LA-Solarpunk/free_fridges_monitoring/Hardware/monitoring_system_schematic/monitoring_system_schematic.kicad_sch

## KiCad design Hardware/monitoring_system_schematic/monitoring_system_schematic.kicad_sch (2026-09-17)

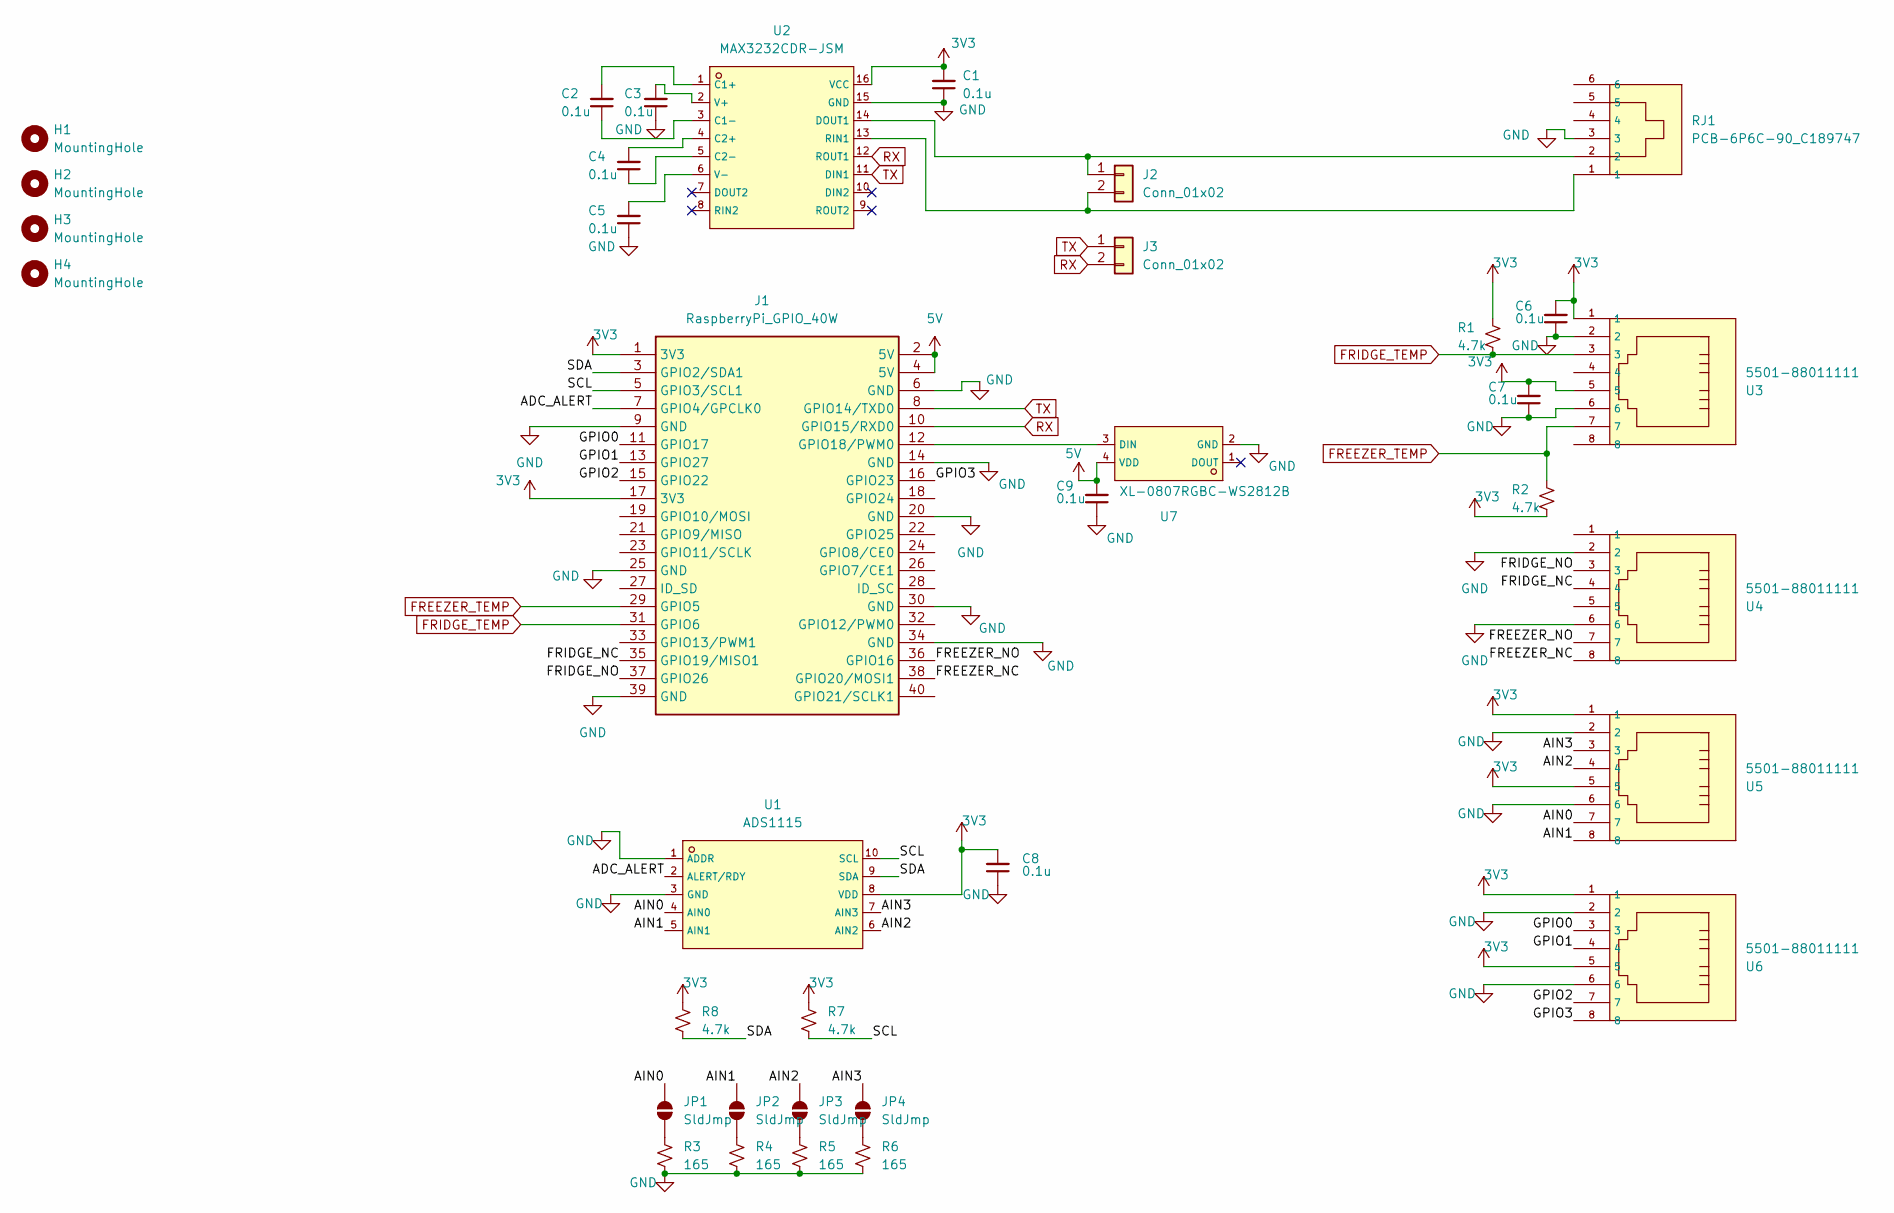
[picture p1: schematic monitoring_system_schematic.kicad_sch]

Parts:
C1, C2, C3, C4, C5, C6, C7, C8, C9: 0.1u; C307331_C0402; LCSC C307331
H1, H2, H3, H4: MountingHole; MountingHole_2.7mm_M2.5_Pad_Via
J1: RaspberryPi_GPIO_40W; RPi_Zero_ModelB_40W_Carrier; LCSC C132132
J2, J3: Conn_01x02; PinHeader_1x02_P2.54mm_Vertical
JP1, JP2, JP3, JP4: SldJmp; SolderJumper-2_P1.3mm_Open_RoundedPad1.0x1.5mm
R1, R2, R7, R8: 4.7k; C25900_R0402; LCSC C25900
R3, R4, R5, R6: 165; C706217_R0805; LCSC C706217
RJ1: PCB-6P6C-90_C189747; C189747_RJ11-TH_PCB-6P6C-90; LCSC C189747
U1: ADS1115; C37593_MSOP-10_L3_0-W3_0-P0_50-LS5_0-BL; LCSC C37593
U2: MAX3232CDR-JSM; C46596312_SOIC-16_L9_9-W3_9-P1_27-LS6_1-BL; LCSC C46596312
U3, U4, U5, U6: 5501-88011111; C3097726_RJ45-TH_FRJ45017-1100G1K0200; LCSC C3097726
U7: XL-0807RGBC-WS2812B; C3646929_LED-SMD_4P-L2_0-W1_8_XL-0807RGBC-WS2812B; LCSC C3646929

Connections:
3V3: C1.2, C6.2, C7.2, C8.2, J1.1 (3V3), J1.17 (3V3), R1.1, R2.2, R7.1, R8.1, U1.8 (VDD), U2.16 (VCC), U3.1, U3.5, U5.1, U5.5, U6.1, U6.5
5V: C9.2, J1.2 (5V), J1.4 (5V), U7.4 (VDD)
ADC_ALERT: J1.7 (GPIO4/GPCLK0), U1.2 (ALERT/RDY)
AIN0: JP1.2 (B), U1.4 (AIN0), U5.7
AIN1: JP2.2 (B), U1.5 (AIN1), U5.8
AIN2: JP3.2 (B), U1.6 (AIN2), U5.4
AIN3: JP4.2 (B), U1.7 (AIN3), U5.3
FREEZER_NC: J1.38 (GPIO20/MOSI1), U4.8
FREEZER_NO: J1.36 (GPIO16), U4.7
FREEZER_TEMP: J1.29 (GPIO5), R2.1, U3.7
FRIDGE_NC: J1.35 (GPIO19/MISO1), U4.4
FRIDGE_NO: J1.37 (GPIO26), U4.3
FRIDGE_TEMP: J1.31 (GPIO6), R1.2, U3.3
GND: C1.1, C3.1, C5.1, C6.1, C7.1, C8.1, C9.1, J1.6 (GND), J1.9 (GND), J1.14 (GND), J1.20 (GND), J1.25 (GND), J1.30 (GND), J1.34 (GND), J1.39 (GND), R3.2, R4.2, R5.2, R6.2, RJ1.3, U1.1 (ADDR), U1.3 (GND), U2.15 (GND), U3.2, U3.6, U4.2, U4.6, U5.2, U5.6, U6.2, U6.6, U7.2 (GND)
GPIO0: J1.11 (GPIO17), U6.3
GPIO1: J1.13 (GPIO27), U6.4
GPIO2: J1.15 (GPIO22), U6.7
GPIO3: J1.16 (GPIO23), U6.8
unnamed: C2.1, U2.3 (C1-)
unnamed: C2.2, U2.1 (C1+)
unnamed: C3.2, U2.2 (V+)
unnamed: C4.1, U2.5 (C2-)
unnamed: C4.2, U2.4 (C2+)
unnamed: C5.2, U2.6 (V-)
unnamed: J1.12 (GPIO18/PWM0), U7.3 (DIN)
unnamed: J2.1, RJ1.2, U2.14 (DOUT1)
unnamed: J2.2, RJ1.1, U2.13 (RIN1)
unnamed: JP1.1 (A), R3.1
unnamed: JP2.1 (A), R4.1
unnamed: JP3.1 (A), R5.1
unnamed: JP4.1 (A), R6.1
RX: J1.10 (GPIO15/RXD0), J3.2, U2.12 (ROUT1)
SCL: J1.5 (GPIO3/SCL1), R7.2, U1.10 (SCL)
SDA: J1.3 (GPIO2/SDA1), R8.2, U1.9 (SDA)
TX: J1.8 (GPIO14/TXD0), J3.1, U2.11 (DIN1)
