LA-Solarpunk/free_fridges_monitoring/Software/Client/monitor_client.py

import os
import time
import logging
from datetime import datetime

import schedule

import temperature_interface
import door_sensor_interface
import charge_interface
import mqtt
import messages
import config
import json

"""
This is the main file for the monitoring client. It creates a basic hourly and monthly scheduler to
pull data hourly and save that data to gdrive monthly.

TODO(Heidt) - hourly schedules are ok if missed, but monthly is bad. If there's an issue, a month may not
              get logged. Should maybe make a database or just simple local log to determine when things have
              happened and use that as reference.
TODO(Heidt) - should probably move away from script approach to module approach to aid testing
TODO(Heidt) - add error messaging for each sensor
"""

logger = logging.getLogger(__name__)
logging.basicConfig(
    format="%(asctime)s [%(levelname)s] - %(message)s", level=logging.INFO
)
settings = config.load_settings()
FRIDGE_ID = settings.device.device_id

charge_controller = charge_interface.ChargeInterface()
door_sensors = door_sensor_interface.DoorSensorManager()
mqtt_client = mqtt.connect_mqtt()

# assuming fridge, freezer ordering
gpio_pins = [5, 6]


def get_entry():
    # TODO(Heidt) probably make a data aggregator type class to put all this logic
    temperature_data = temperature_interface.get_temperatures(gpio_pins)

    charge_reading = charge_controller.get_charge_data()        
    fridge_door_state, fridge_door_open_count, fridge_door_open_time = door_sensors.get_fridge_door()
    freezer_door_state, freezer_door_open_count, freezer_door_open_time = door_sensors.get_freezer_door()

    entry = messages.SensorEntry(
        temperature_data[gpio_pins[0]],
        temperature_data[gpio_pins[1]],
        charge_reading,
        fridge_door_state,
        fridge_door_open_count,
        fridge_door_open_time,
        freezer_door_state,
        freezer_door_open_count,
        freezer_door_open_time,
        FRIDGE_ID
    )
    return entry


def send_data():
    entry = get_entry()
    logger.info(f"Publishing new entry to mqtt: {json.dumps(json.loads(entry.get_json_string()), indent=4)}")
    mqtt.publish_data(mqtt_client, entry)

def update_sensors():
    door_sensors.update_status()

def main():
    logger.info("Starting monitoring client")
    schedule.every(1).minutes.do(send_data)
    schedule.every(1).seconds.do(update_sensors)

    while True:
        schedule.run_pending()
        time.sleep(1)


if __name__ == "__main__":
    main()
