LA-Solarpunk/free_fridges_monitoring/(commit log)

2025-10-06 Added gitignore, updated README, created initial dummy version of airtable posting with real temperature data from DS18B20
2025-10-13 Fixed airtable.py fridge ID printing functionality
2025-10-13 Renamed door file to include both types of sensors. Added code to actually read state.
2025-10-14 Added RPi.GPIO to requirements. Fixed magnet sensor setup. Updated readme to reflect that token.json can be theoretically re-used.
2025-10-17 Added basic charge interface with address check
2025-10-19 Fixed some issues with the charge interface handling when there are connection issues. Added an error column to airtable.
    [charge_interface.py, monitor_client.py]
2025-10-19 Fixed bug in airtable data conversion for door sensor, added some basic integration tests
    [monitor_client.py]
2026-04-16 Added some integration tests and updated temp interface for multiple sensors
2026-04-19 Added functionality to check for broken pins on the magnet sensors
    [door_sensor_interface.py, messages.py, monitor_client.py, temperature_interface.py]
2026-05-03 Added sensor reading type to capture data and errors
    [charge_interface.py, config.py, door_sensor_interface.py, messages.py, monitor_client.py, mqtt.py, temperature_interface.py]
2026-05-05 Fixed bug in door monitoring code, added sysd service definition
    [door_sensor_interface.py, messages.py, monitor_client.py]
2026-09-07 Remove unused Airtable and Google Drive integrations
    The client no longer publishes to Airtable or uploads to Google Drive,
    so drop the dead modules, their config/env vars, requirements, and
    README setup instructions.
    [config.py]
2026-09-11 Mask MQTT password from logged config output
    load_settings() logs the full Settings object via pprint.pformat(),
    which previously included the plaintext MQTT broker password since
    it runs under a systemd service that ships stdout to the journal.
    [config.py]
2026-09-11 Note tailnet-only transport encryption assumption for MQTT
    We currently rely on the broker being reachable only over Tailscale
    for encryption in transit, with no TLS configured at the MQTT layer.
    Documenting this as a TODO so we revisit it if that assumption ever
    changes.
    [mqtt.py]
2026-09-11 Initial hardware commit, not currently functional
2026-09-17 Rev A routed and complete for the schematic
